ThBreuer/ORB-Hardware/README.md

# ORB-Hardware
OpenRoboticBoard: schematics, layout and documentation
