ThBreuer/ORB-Hardware/Ver-01.xx/Doc/Hardware-Overview.png

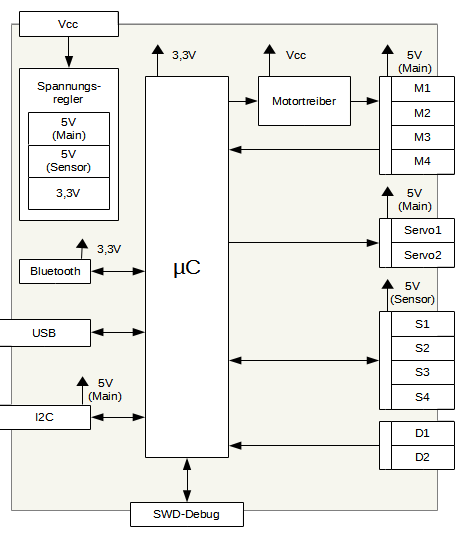
Ver-01.xx/Doc/Hardware-Overview.png
