ThBreuer/ORB-Hardware/Ver-01.xx/KiCad/ORB.kicad_pcb

## KiCad design Ver-01.xx/KiCad/ORB.kicad_pcb (2024-05-07)

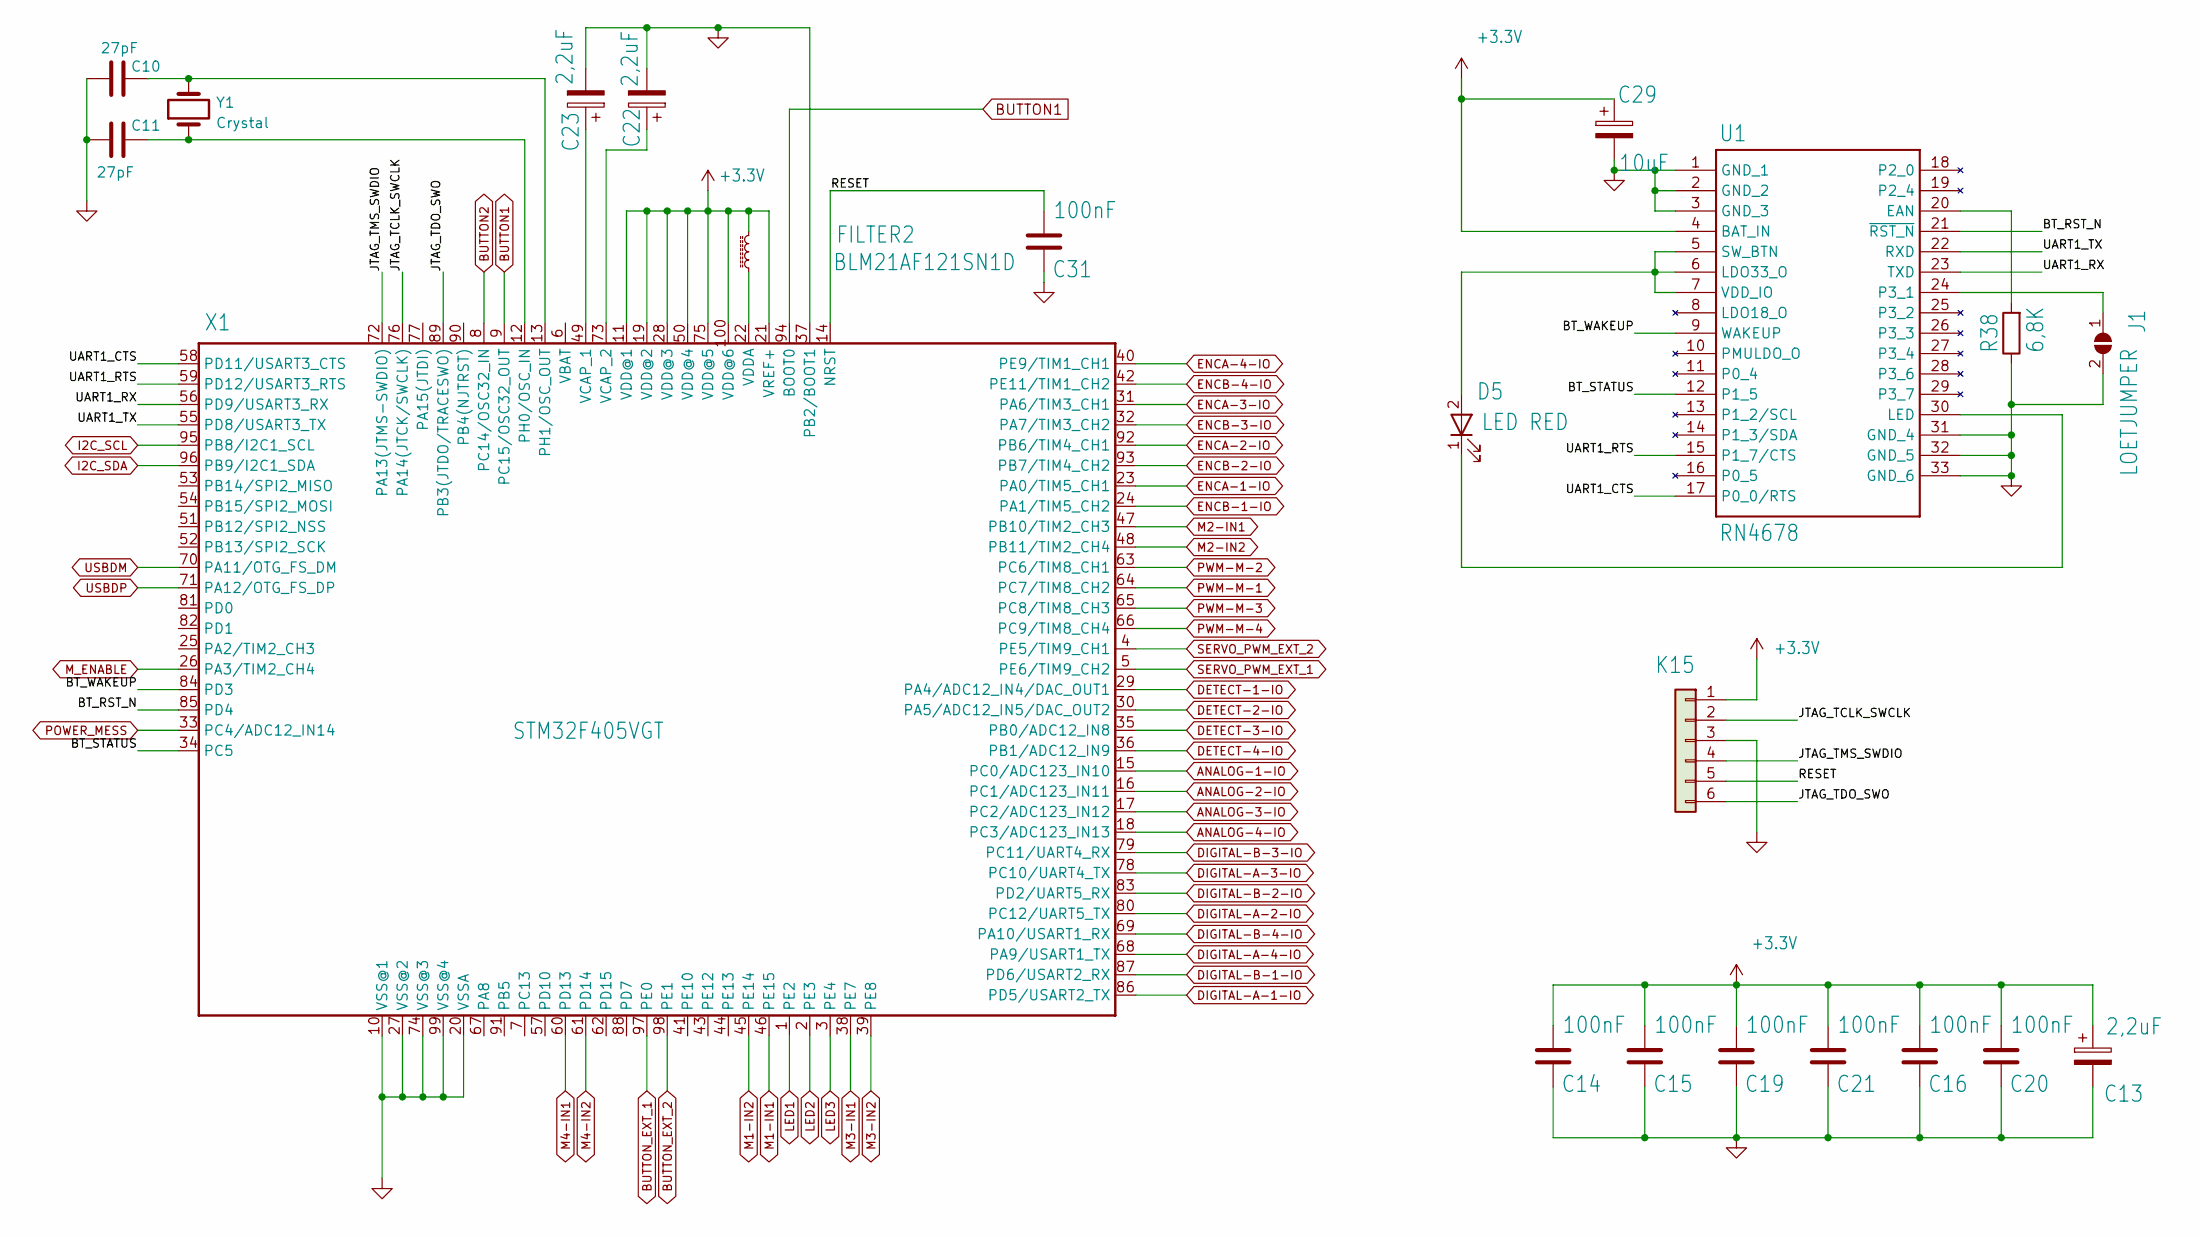
[picture p10: schematic Controller_Bluetooth.kicad_sch, Open Robotic Board (ORB)]

Parts:
C10, C11: 27pF; C_0805_2012Metric; MPN C0805C270K8HAC7800
C13, C22, C23: 2,2uF; CP_EIA-3216-10_Kemet-I; MPN T491A225K016AT
C14, C15, C16, C19, C20, C21, C31: 100nF; C_0805_2012Metric; MPN C0805C104K5RAC7800
C29: 10uF; CP_EIA-3528-12_Kemet-T; MPN T491B106M025AT
D5: LED RED; LED_0805_2012Metric; MPN QTLP630C7TR
FILTER2: BLM21AF121SN1D; L_0805_2012Metric; MPN BLM21AG121SN1D
J1: LOETJUMPER; SolderJumper-2_P1.3mm_Open_Pad1.0x1.5mm; MPN not mounted
K15: Stiftleiste_1x06; PinHeader_1x06_P2.54mm_Vertical; MPN not mounted
R38: 6,8K; R_0603_1608Metric; MPN RC0603FR-136K8L
U1: RN4678; MODULE_RN4678-V_RM100; MPN RN4678-V/RM113
X1: STM32F405VGT; LQFP-100_14x14mm_P0.5mm; MPN STM32F405VGT6
Y1: Crystal; Crystal_SMD_Abracon_ABM3-2Pin_5.0x3.2mm; MPN ECS-80-18-30-JGN-TR

Connections:
+3V3: C13.1, C14.2, C15.2, C16.2, C19.2, C20.2, C21.2, C29.1, FILTER2.2, K15.1, U1.4 (BAT_IN), X1.11 (VDD@1), X1.19 (VDD@2), X1.21 (VREF+), X1.28 (VDD@3), X1.50 (VDD@4), X1.75 (VDD@5), X1.100 (VDD@6); also elsewhere on the board
/Controller, Bluetooth/BT_RST_N: U1.21 (~RST_N), X1.85 (PD4)
/Controller, Bluetooth/BT_STATUS: U1.12 (P1_5), X1.34 (PC5)
/Controller, Bluetooth/BT_WAKEUP: U1.9 (WAKEUP), X1.84 (PD3)
/Controller, Bluetooth/JTAG_TCLK_SWCLK: K15.2, X1.76 (PA14(JTCK/SWCLK))
/Controller, Bluetooth/JTAG_TDO_SWO: K15.6, X1.89 (PB3(JTDO/TRACESWO))
/Controller, Bluetooth/JTAG_TMS_SWDIO: K15.4, X1.72 (PA13(JTMS-SWDIO))
/Controller, Bluetooth/RESET: C31.2, K15.5, X1.14 (NRST)
/Controller, Bluetooth/UART1_CTS: U1.17 (P0_0/RTS), X1.58 (PD11/USART3_CTS)
/Controller, Bluetooth/UART1_RTS: U1.15 (P1_7/CTS), X1.59 (PD12/USART3_RTS)
/Controller, Bluetooth/UART1_RX: U1.23 (TXD), X1.56 (PD9/USART3_RX)
/Controller, Bluetooth/UART1_TX: U1.22 (RXD), X1.55 (PD8/USART3_TX)
ANALOG-1-IO: X1.15 (PC0/ADC123_IN10); also elsewhere on the board
ANALOG-2-IO: X1.16 (PC1/ADC123_IN11); also elsewhere on the board
ANALOG-3-IO: X1.17 (PC2/ADC123_IN12); also elsewhere on the board
ANALOG-4-IO: X1.18 (PC3/ADC123_IN13); also elsewhere on the board
BUTTON1: X1.9 (PC15/OSC32_OUT), X1.94 (BOOT0); also elsewhere on the board
BUTTON2: X1.8 (PC14/OSC32_IN); also elsewhere on the board
BUTTON_EXT_1: X1.97 (PE0); also elsewhere on the board
BUTTON_EXT_2: X1.98 (PE1); also elsewhere on the board
DETECT-1-IO: X1.29 (PA4/ADC12_IN4/DAC_OUT1); also elsewhere on the board
DETECT-2-IO: X1.30 (PA5/ADC12_IN5/DAC_OUT2); also elsewhere on the board
DETECT-3-IO: X1.35 (PB0/ADC12_IN8); also elsewhere on the board
DETECT-4-IO: X1.36 (PB1/ADC12_IN9); also elsewhere on the board
DIGITAL-A-1-IO: X1.86 (PD5/USART2_TX); also elsewhere on the board
DIGITAL-A-2-IO: X1.80 (PC12/UART5_TX); also elsewhere on the board
DIGITAL-A-3-IO: X1.78 (PC10/UART4_TX); also elsewhere on the board
DIGITAL-A-4-IO: X1.68 (PA9/USART1_TX); also elsewhere on the board
DIGITAL-B-1-IO: X1.87 (PD6/USART2_RX); also elsewhere on the board
DIGITAL-B-2-IO: X1.83 (PD2/UART5_RX); also elsewhere on the board
DIGITAL-B-3-IO: X1.79 (PC11/UART4_RX); also elsewhere on the board
DIGITAL-B-4-IO: X1.69 (PA10/USART1_RX); also elsewhere on the board
ENCA-1-IO: X1.23 (PA0/TIM5_CH1); also elsewhere on the board
ENCA-2-IO: X1.92 (PB6/TIM4_CH1); also elsewhere on the board
ENCA-3-IO: X1.31 (PA6/TIM3_CH1); also elsewhere on the board
ENCA-4-IO: X1.40 (PE9/TIM1_CH1); also elsewhere on the board
ENCB-1-IO: X1.24 (PA1/TIM5_CH2); also elsewhere on the board
ENCB-2-IO: X1.93 (PB7/TIM4_CH2); also elsewhere on the board
ENCB-3-IO: X1.32 (PA7/TIM3_CH2); also elsewhere on the board
ENCB-4-IO: X1.42 (PE11/TIM1_CH2); also elsewhere on the board
GND: C10.1, C11.1, C13.2, C14.1, C15.1, C16.1, C19.1, C20.1, C21.1, C22.2, C23.2, C29.2, C31.1, J1.2 (B), K15.3, R38.1, U1.1 (GND_1), U1.2 (GND_2), U1.3 (GND_3), U1.31 (GND_4), U1.32 (GND_5), U1.33 (GND_6), X1.10 (VSS@1), X1.20 (VSSA), X1.27 (VSS@2), X1.37 (PB2/BOOT1), X1.74 (VSS@3), X1.99 (VSS@4); also elsewhere on the board
I2C_SCL: X1.95 (PB8/I2C1_SCL); also elsewhere on the board
I2C_SDA: X1.96 (PB9/I2C1_SDA); also elsewhere on the board
LED1: X1.1 (PE2); also elsewhere on the board
LED2: X1.2 (PE3); also elsewhere on the board
LED3: X1.3 (PE4); also elsewhere on the board
M1-IN1: X1.46 (PE15); also elsewhere on the board
M1-IN2: X1.45 (PE14); also elsewhere on the board
M2-IN1: X1.47 (PB10/TIM2_CH3); also elsewhere on the board
M2-IN2: X1.48 (PB11/TIM2_CH4); also elsewhere on the board
M3-IN1: X1.38 (PE7); also elsewhere on the board
M3-IN2: X1.39 (PE8); also elsewhere on the board
M4-IN1: X1.60 (PD13); also elsewhere on the board
M4-IN2: X1.61 (PD14); also elsewhere on the board
M_ENABLE: X1.26 (PA3/TIM2_CH4); also elsewhere on the board
unnamed: D5.2 (A), U1.5 (SW_BTN), U1.6 (LDO33_O), U1.7 (VDD_IO)
unnamed: D5.1 (K), U1.30 (LED)
unnamed: J1.1 (A), U1.24 (P3_1)
unnamed: R38.2, U1.20 (EAN)
unnamed: C11.2, X1.12 (PH0/OSC_IN), Y1.1
unnamed: C10.2, X1.13 (PH1/OSC_OUT), Y1.2
unnamed: C23.1, X1.49 (VCAP_1)
unnamed: C22.1, X1.73 (VCAP_2)
unnamed: FILTER2.1, X1.22 (VDDA)
POWER_MESS: X1.33 (PC4/ADC12_IN14); also elsewhere on the board
PWM-M-1: X1.64 (PC7/TIM8_CH2); also elsewhere on the board
PWM-M-2: X1.63 (PC6/TIM8_CH1); also elsewhere on the board
PWM-M-3: X1.65 (PC8/TIM8_CH3); also elsewhere on the board
PWM-M-4: X1.66 (PC9/TIM8_CH4); also elsewhere on the board
SERVO_PWM_EXT_1: X1.5 (PE6/TIM9_CH2); also elsewhere on the board
SERVO_PWM_EXT_2: X1.4 (PE5/TIM9_CH1); also elsewhere on the board
USBDM: X1.70 (PA11/OTG_FS_DM); also elsewhere on the board
USBDP: X1.71 (PA12/OTG_FS_DP); also elsewhere on the board

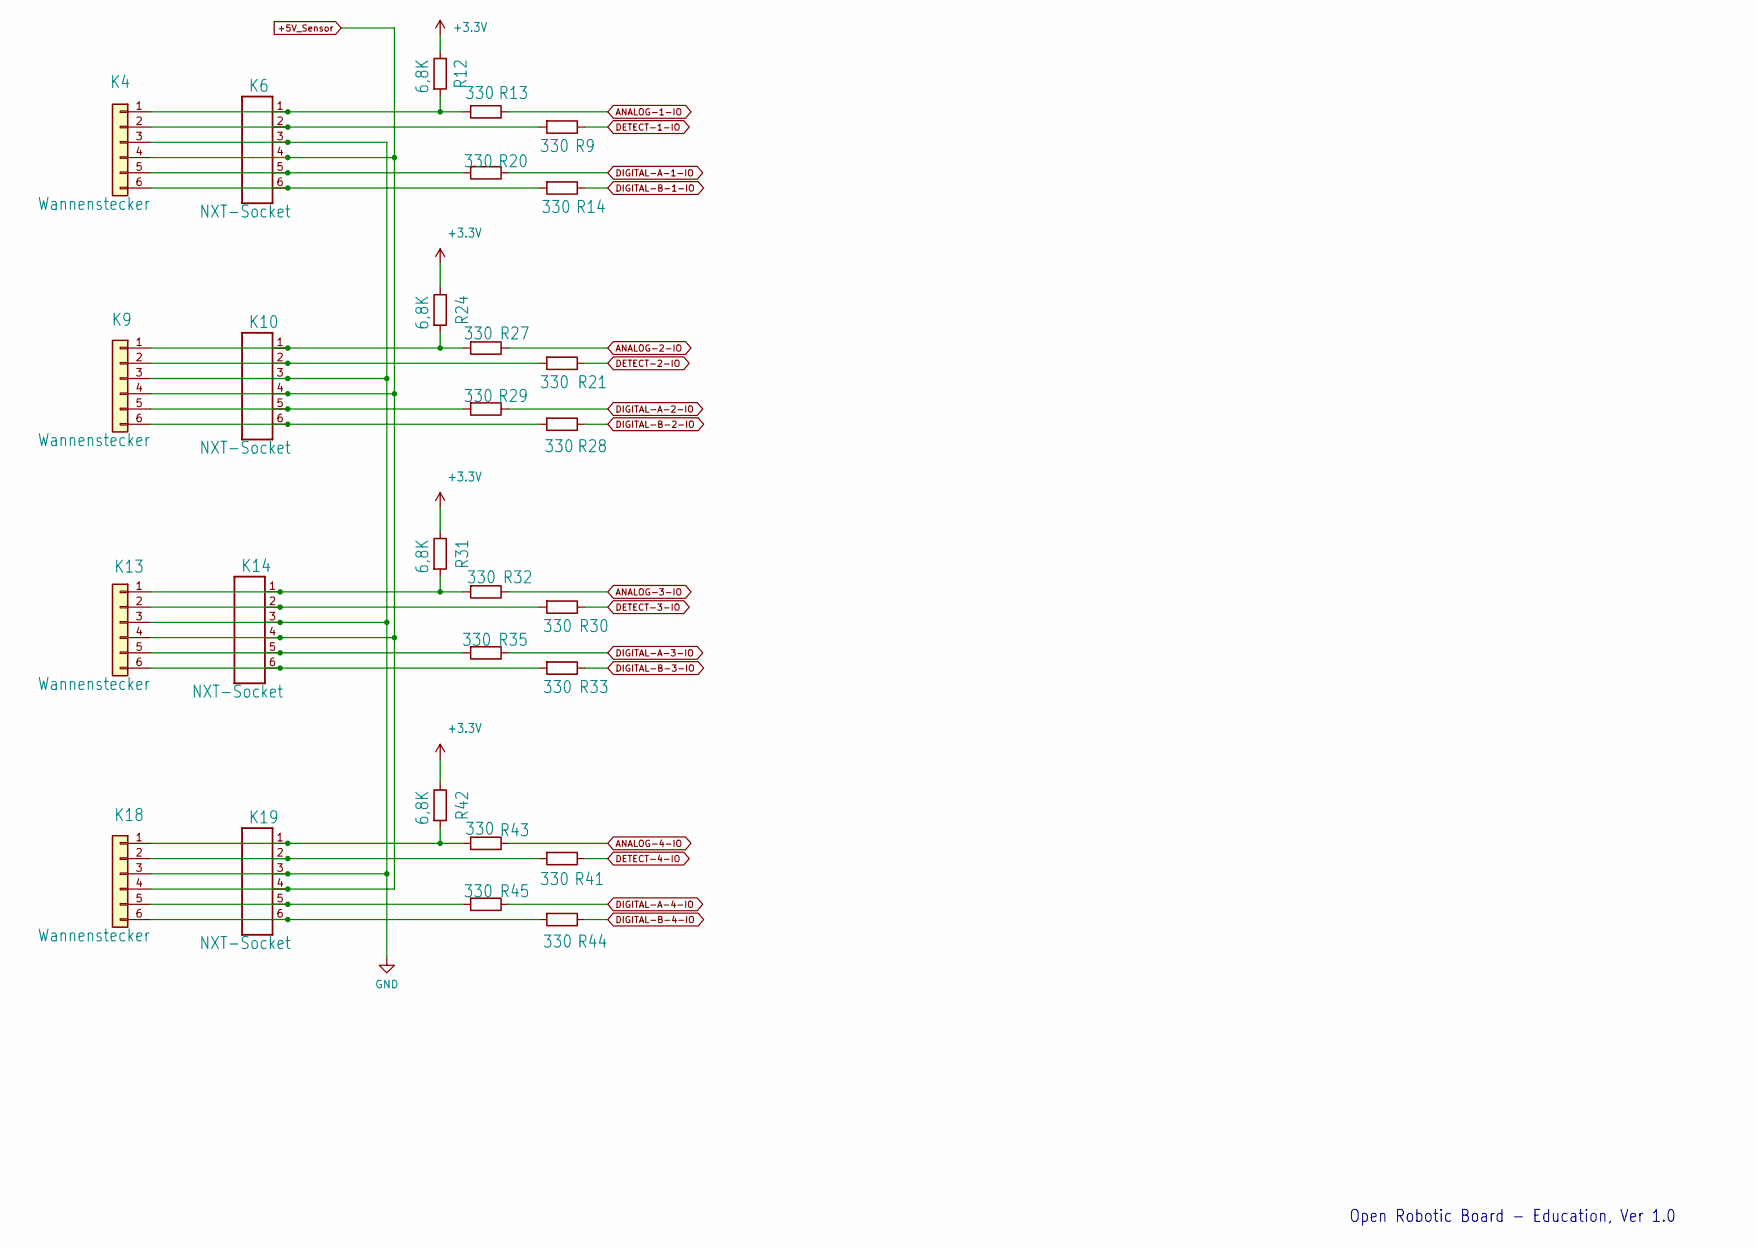
[picture p11: schematic Sensor_Ports.kicad_sch, Open Robotic Board (ORB)]

Parts:
K4, K9, K13, K18: Wannenstecker; IDC-Header_2x03_P2.54mm_Vertical; MPN not mounted
K6, K10, K14, K19: NXT-Socket; NXT-SOCKET; MPN NXT/EV3 Compatible (female) Sockets
R9, R13, R14, R20, R21, R27, R28, R29, R30, R32, R33, R35, R41, R43, R44, R45: 330; R_0603_1608Metric; MPN RC0603FR-10330RL
R12, R24, R31, R42: 6,8K; R_0603_1608Metric; MPN RC0603FR-136K8L

Connections:
+3V3: R12.1, R24.1, R31.1, R42.1; also elsewhere on the board
+5V_Sensor: K4.4, K6.4, K9.4, K10.4, K13.4, K14.4, K18.4, K19.4; also elsewhere on the board
ANALOG-1-IO: R13.1; also elsewhere on the board
ANALOG-2-IO: R27.1; also elsewhere on the board
ANALOG-3-IO: R32.1; also elsewhere on the board
ANALOG-4-IO: R43.1; also elsewhere on the board
DETECT-1-IO: R9.1; also elsewhere on the board
DETECT-2-IO: R21.1; also elsewhere on the board
DETECT-3-IO: R30.1; also elsewhere on the board
DETECT-4-IO: R41.1; also elsewhere on the board
DIGITAL-A-1-IO: R20.1; also elsewhere on the board
DIGITAL-A-2-IO: R29.1; also elsewhere on the board
DIGITAL-A-3-IO: R35.1; also elsewhere on the board
DIGITAL-A-4-IO: R45.1; also elsewhere on the board
DIGITAL-B-1-IO: R14.1; also elsewhere on the board
DIGITAL-B-2-IO: R28.1; also elsewhere on the board
DIGITAL-B-3-IO: R33.1; also elsewhere on the board
DIGITAL-B-4-IO: R44.1; also elsewhere on the board
GND: K4.3, K6.3, K9.3, K10.3, K13.3, K14.3, K18.3, K19.3; also elsewhere on the board
unnamed: K4.1, K6.1, R12.2, R13.2
unnamed: K4.2, K6.2, R9.2
unnamed: K4.5, K6.5, R20.2
unnamed: K4.6, K6.6, R14.2
unnamed: K9.1, K10.1, R24.2, R27.2
unnamed: K9.2, K10.2, R21.2
unnamed: K9.5, K10.5, R29.2
unnamed: K9.6, K10.6, R28.2
unnamed: K13.1, K14.1, R31.2, R32.2
unnamed: K13.2, K14.2, R30.2
unnamed: K13.5, K14.5, R35.2
unnamed: K13.6, K14.6, R33.2
unnamed: K18.1, K19.1, R42.2, R43.2
unnamed: K18.2, K19.2, R41.2
unnamed: K18.5, K19.5, R45.2
unnamed: K18.6, K19.6, R44.2

Notes on the sheet:
Open Robotic Board - Education, Ver 1.0

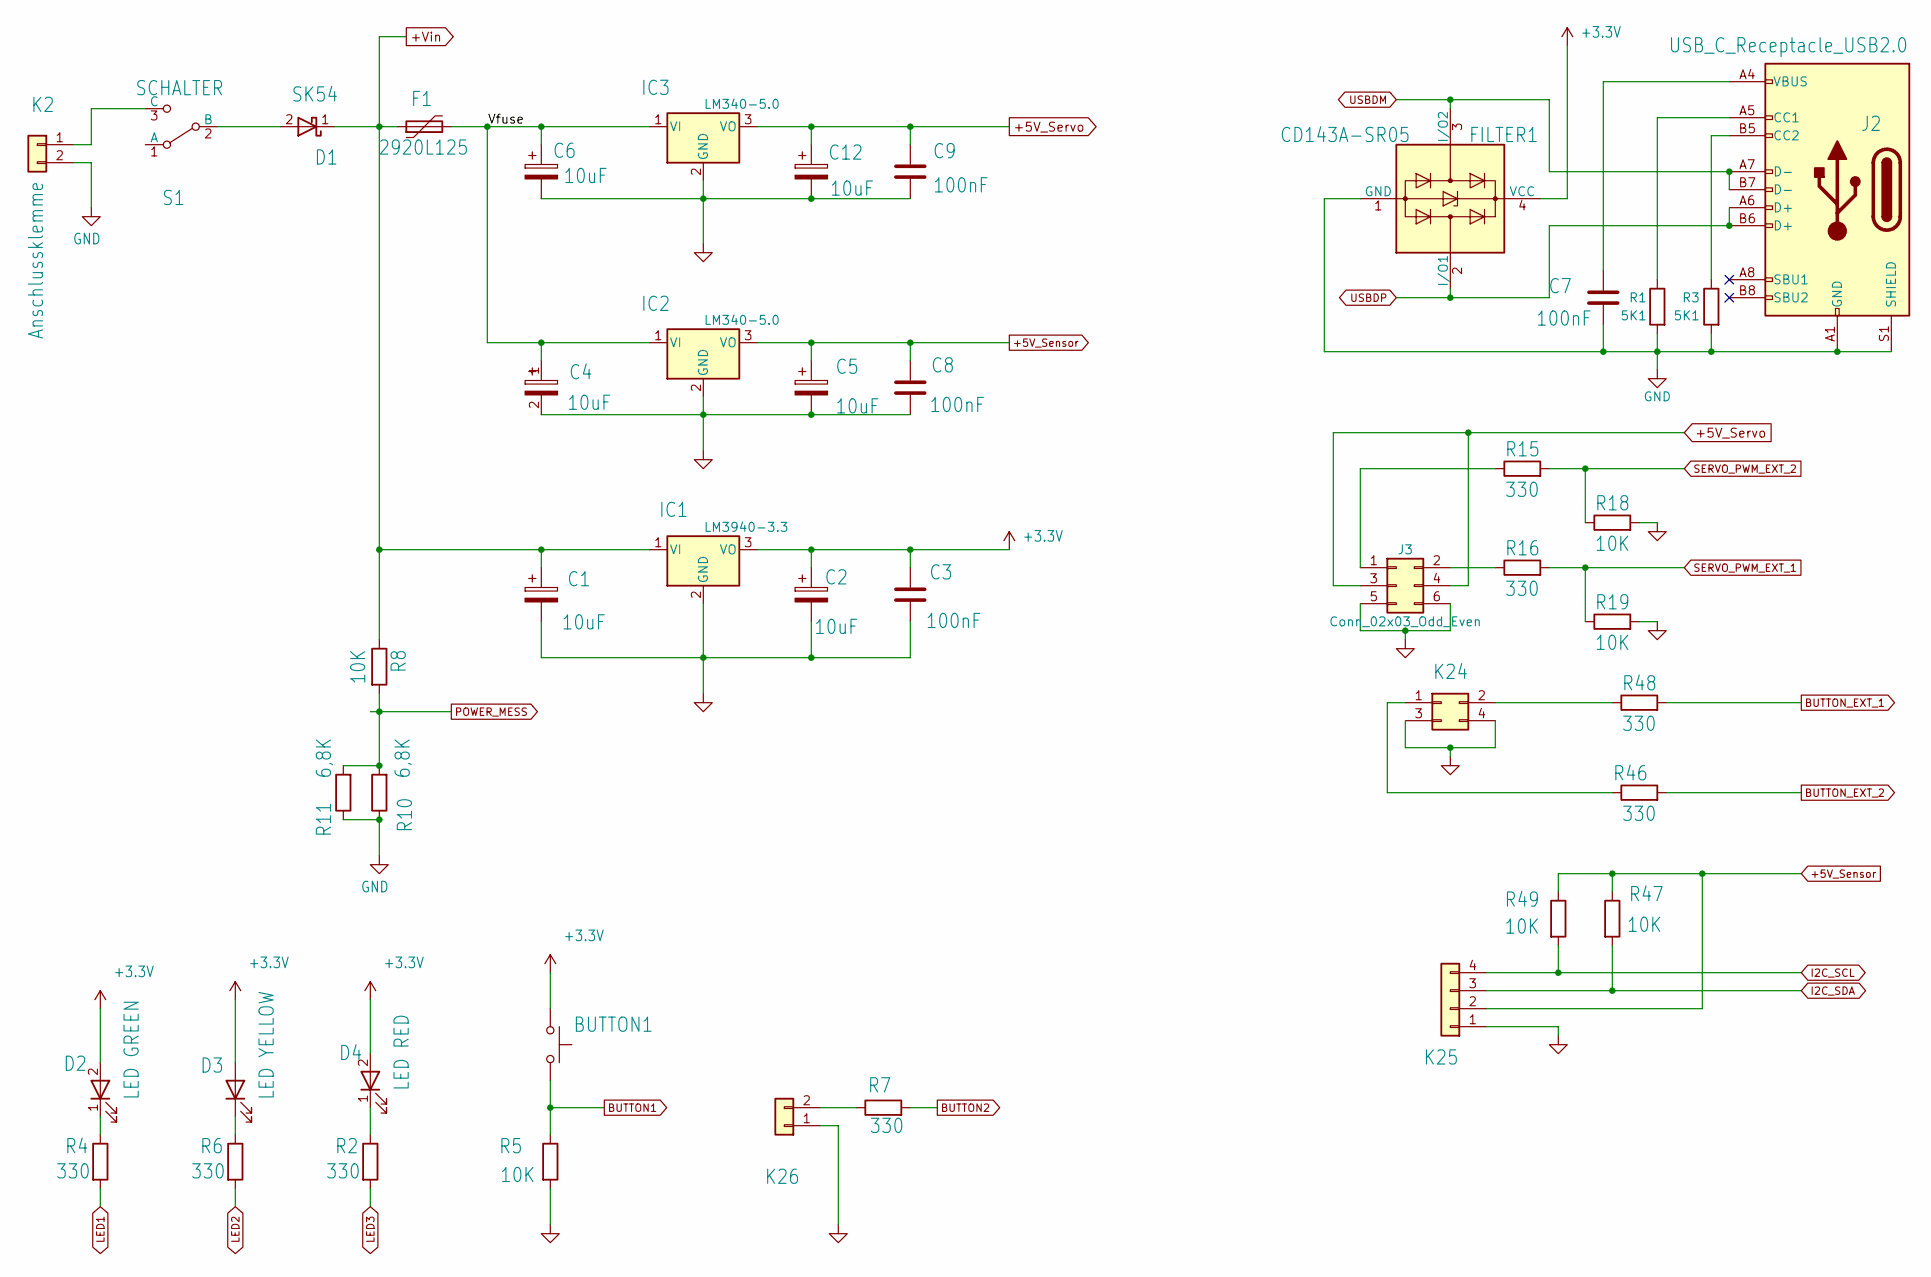
[picture p12: schematic Power_LED_Tasten_IO.kicad_sch, Open Robotic Board (ORB)]

Parts:
BUTTON1: Taster_SMD; SW_Push_1P1T_NO_6x6mm_H9.5mm; MPN PTS645SL70SMTR92 LFS
C1, C2, C4, C5, C6, C12: 10uF; CP_EIA-3528-12_Kemet-T; MPN T491B106M025AT
C3, C7, C8, C9: 100nF; C_0805_2012Metric; MPN C0805C104K5RAC7800
D1: SK54; D_SMB; MPN SK54B-LTP
D2: LED GREEN; LED_0805_2012Metric; MPN QTLP630C4TR
D3: LED YELLOW; LED_0805_2012Metric; MPN QTLP630C3TR
D4: LED RED; LED_0805_2012Metric; MPN QTLP630C7TR
F1: 2920L125; Fuse_2920_7451Metric; MPN 2920L125PR
FILTER1: CD143A-SR05; SOT-143; MPN CD143A-SR05LC
IC1: LM3940-3.3; SOT-223-3_TabPin2; MPN LM3940IMPX-3.3/NOPB
IC2, IC3: LM340-5.0; SOT-223-3_TabPin2; MPN LM340MPX-5.0/NOPB
J2: USB_C_Receptacle_USB2.0; USB_C_Receptacle_G-Switch_GT-USB-7010ASV; MPN GT-USB-7010ASV
J3: Conn_02x03_Odd_Even; PinHeader_2x03_P2.54mm_Horizontal; MPN PH2RA-06-UA
K2: Anschlussklemme; PinHeader_1x02_P2.54mm_Horizontal; MPN PH1RB-02-UA
K24: Stiftleiste_2x02; PinHeader_2x02_P2.54mm_Horizontal; MPN PH2RA-04-UA
K25: Stiftleiste_1x04; PinHeader_1x04_P2.54mm_Vertical; MPN not mounted
K26: Stiftleiste_1x02_G_2,54; PinHeader_1x02_P2.54mm_Vertical; MPN not mounted
R1, R3: 5K1; R_0603_1608Metric; MPN RC0603FR-135K1L
R2, R4, R6, R7, R15, R16, R46, R48: 330; R_0603_1608Metric; MPN RC0603FR-10330RL
R5, R8, R18, R19, R47, R49: 10K; R_0603_1608Metric; MPN RC0603FR-0710KP
R10, R11: 6,8K; R_0603_1608Metric; MPN RC0603FR-136K8L
S1: SCHALTER; SW_500SSP1S1M7QEA; MPN 500SSP1S1M7QEA

Connections:
+3V3: BUTTON1.1, C2.1, C3.2, D2.2 (A), D3.2 (A), D4.2 (A), FILTER1.4 (VCC), IC1.3 (VO); also elsewhere on the board
+5V_Sensor: C5.1, C8.2, IC2.3 (VO), K25.2, R47.1, R49.1; also elsewhere on the board
+5V_Servo: C9.2, C12.1, IC3.3 (VO), J3.3, J3.4
+Vin: C1.1, D1.1 (K), F1.1, IC1.1 (VI), R8.1; also elsewhere on the board
/Power, LED,Tasten, IO/Vfuse: C4.1, C6.1, F1.2, IC2.1 (VI), IC3.1 (VI)
BUTTON1: BUTTON1.2, R5.1; also elsewhere on the board
BUTTON2: R7.2; also elsewhere on the board
BUTTON_EXT_1: R48.2; also elsewhere on the board
BUTTON_EXT_2: R46.2; also elsewhere on the board
GND: C1.2, C2.2, C3.1, C4.2, C5.2, C6.2, C7.1, C8.1, C9.1, C12.2, FILTER1.1 (GND), IC1.2 (GND), IC2.2 (GND), IC3.2 (GND), J2.A1 (GND), J2.A12 (GND), J2.B1 (GND), J2.B12 (GND), J2.S1 (SHIELD), J3.5, J3.6, K2.2, K24.3, K24.4, K25.1, K26.1, R1.2, R3.2, R5.2, R10.1, R11.1, R18.2, R19.2; also elsewhere on the board
I2C_SCL: K25.4, R49.2; also elsewhere on the board
I2C_SDA: K25.3, R47.2; also elsewhere on the board
LED1: R4.2; also elsewhere on the board
LED2: R6.2; also elsewhere on the board
LED3: R2.2; also elsewhere on the board
unnamed: C7.2, J2.A4 (VBUS), J2.A9 (VBUS), J2.B4 (VBUS), J2.B9 (VBUS)
unnamed: D1.2 (A), S1.2 (B)
unnamed: D2.1 (K), R4.1
unnamed: D3.1 (K), R6.1
unnamed: D4.1 (K), R2.1
unnamed: J2.A5 (CC1), R1.1
unnamed: J2.B5 (CC2), R3.1
unnamed: J3.1, R15.1
unnamed: J3.2, R16.1
unnamed: K2.1, S1.3 (C)
unnamed: K24.1, R46.1
unnamed: K24.2, R48.1
unnamed: K26.2, R7.1
POWER_MESS: R8.2, R10.2, R11.2; also elsewhere on the board
SERVO_PWM_EXT_1: R16.2, R19.1; also elsewhere on the board
SERVO_PWM_EXT_2: R15.2, R18.1; also elsewhere on the board
USBDM: FILTER1.3 (I/O2), J2.A7 (D-), J2.B7 (D-); also elsewhere on the board
USBDP: FILTER1.2 (I/O1), J2.A6 (D+), J2.B6 (D+); also elsewhere on the board

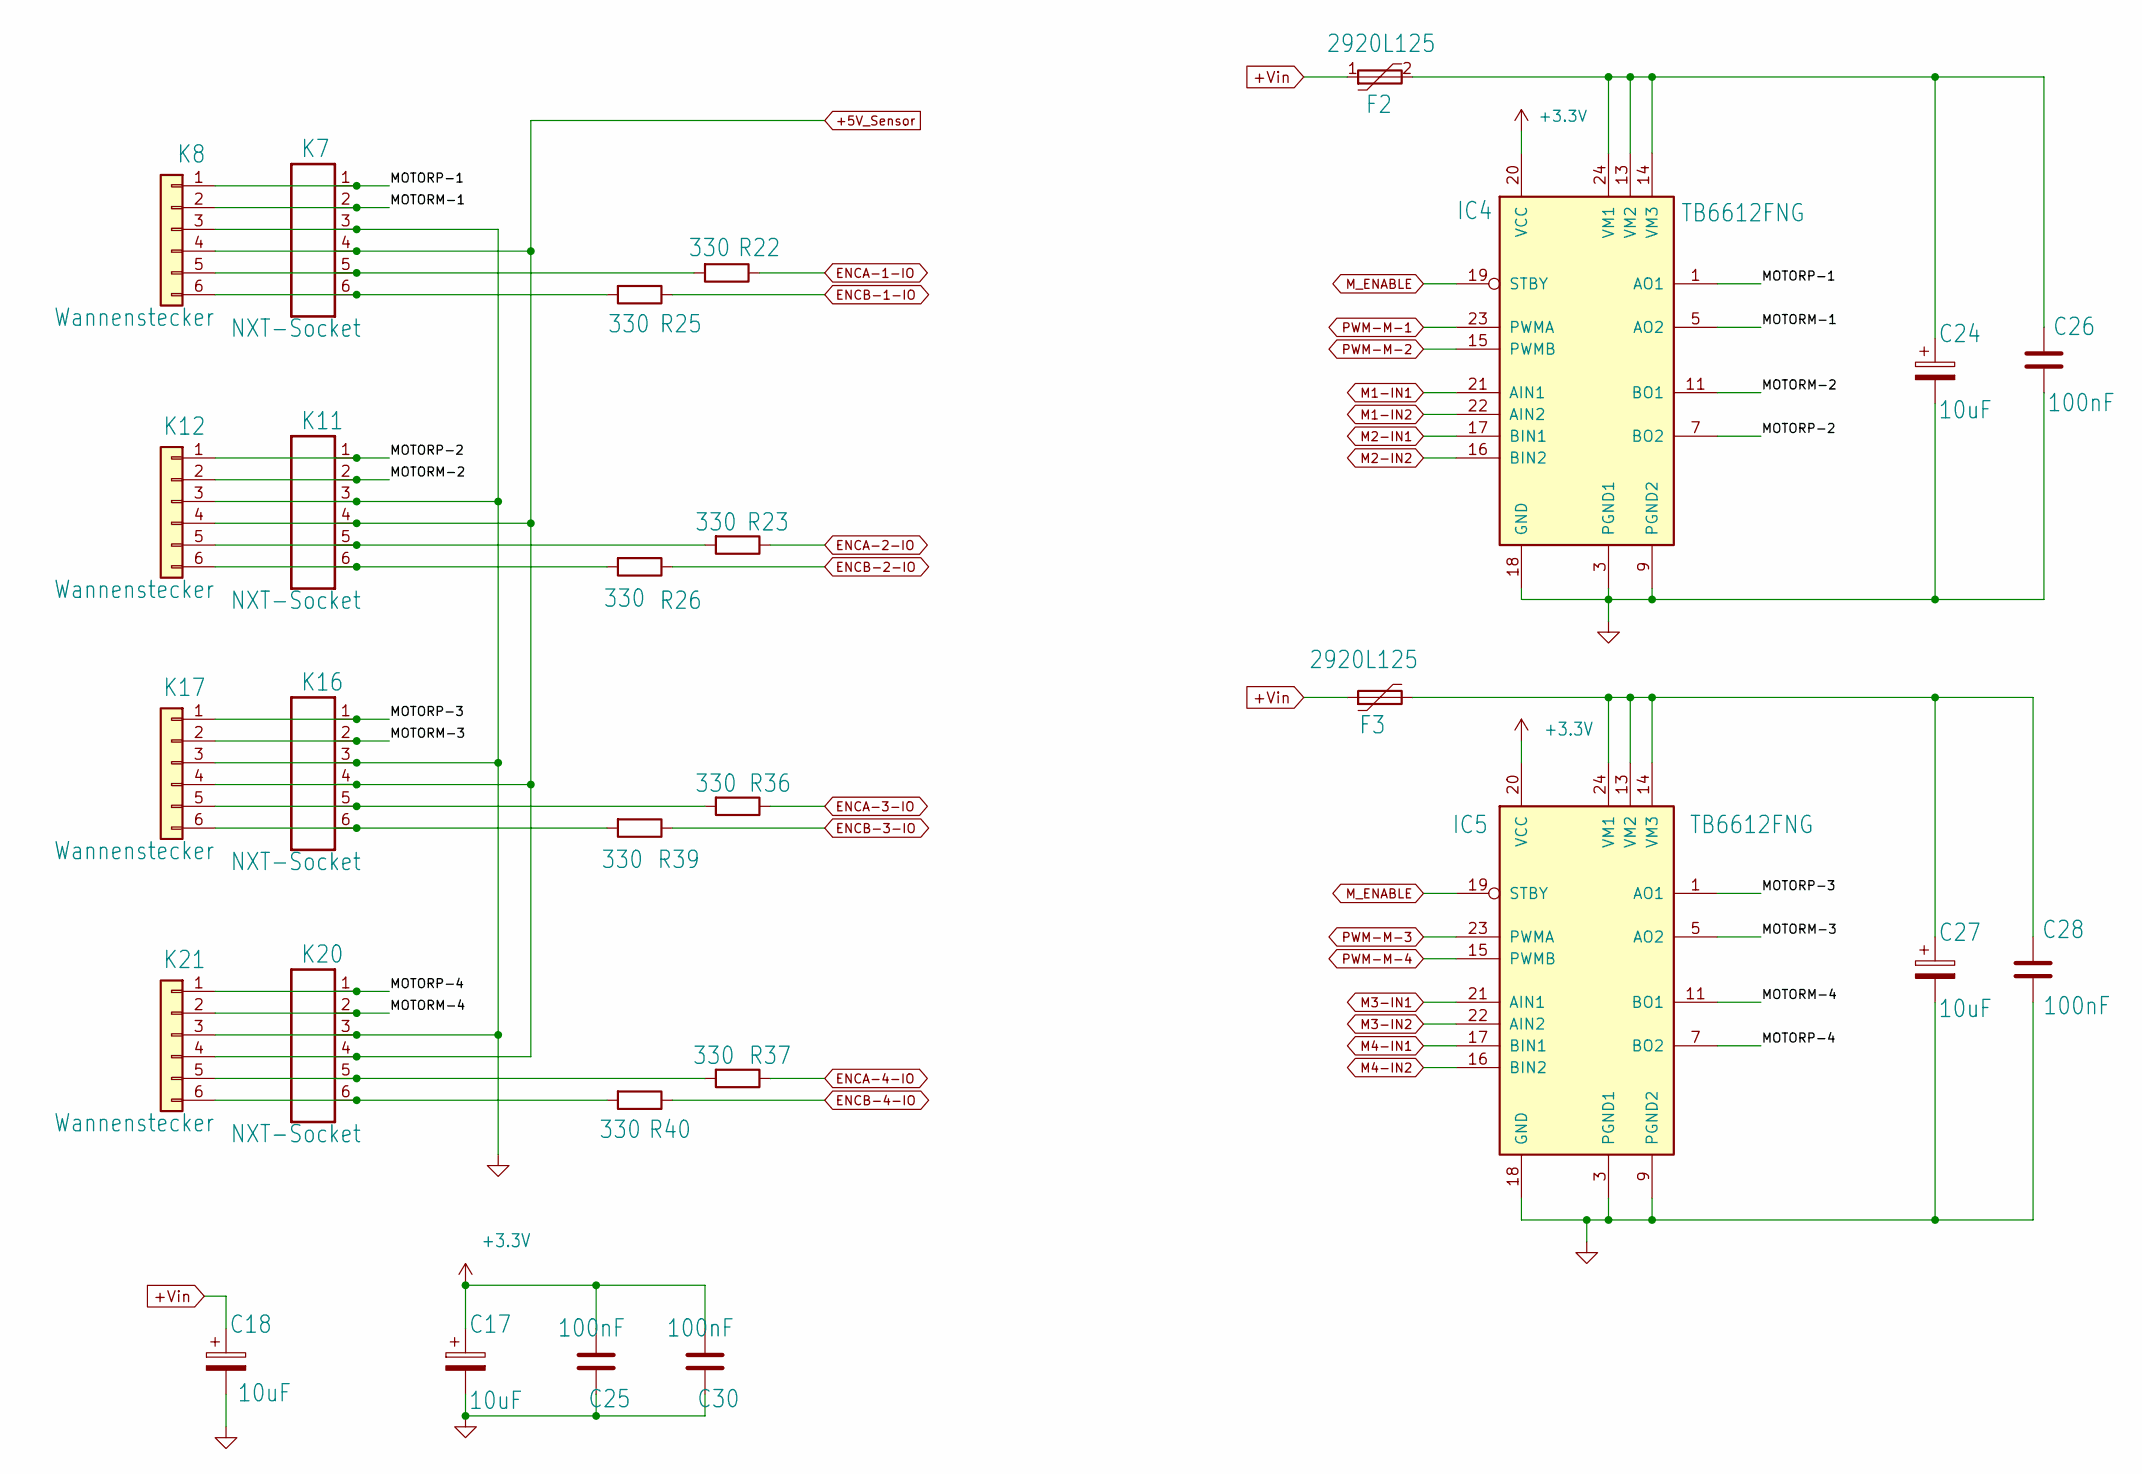
[picture p13: schematic Motor_Ports.kicad_sch, Open Robotic Board (ORB)]

Parts:
C17, C18, C24, C27: 10uF; CP_EIA-3528-12_Kemet-T; MPN T491B106M025AT
C25, C26, C28, C30: 100nF; C_0805_2012Metric; MPN C0805C104K5RAC7800
F2, F3: 2920L125; Fuse_2920_7451Metric; MPN 2920L125PR
IC4, IC5: TB6612FNG; SSOP-24_5.3x8.2mm_P0.65mm; MPN TB6612FNG,C,8,EL
K7, K11, K16, K20: NXT-Socket; NXT-SOCKET; MPN NXT/EV3 Compatible (female) Sockets
K8, K12, K17, K21: Wannenstecker; IDC-Header_2x03_P2.54mm_Vertical; MPN not mounted
R22, R23, R25, R26, R36, R37, R39, R40: 330; R_0603_1608Metric; MPN RC0603FR-10330RL

Connections:
+3V3: C17.1, C25.2, C30.2, IC4.20 (VCC), IC5.20 (VCC); also elsewhere on the board
+5V_Sensor: K7.4, K8.4, K11.4, K12.4, K16.4, K17.4, K20.4, K21.4; also elsewhere on the board
+Vin: C18.1, F2.1, F3.1; also elsewhere on the board
/Motor-Ports/MOTORM-1: IC4.5 (AO2), IC4.6 (AO2), K7.2, K8.2
/Motor-Ports/MOTORM-2: IC4.11 (BO1), IC4.12 (BO1), K11.2, K12.2
/Motor-Ports/MOTORM-3: IC5.5 (AO2), IC5.6 (AO2), K16.2, K17.2
/Motor-Ports/MOTORM-4: IC5.11 (BO1), IC5.12 (BO1), K20.2, K21.2
/Motor-Ports/MOTORP-1: IC4.1 (AO1), IC4.2 (AO1), K7.1, K8.1
/Motor-Ports/MOTORP-2: IC4.7 (BO2), IC4.8 (BO2), K11.1, K12.1
/Motor-Ports/MOTORP-3: IC5.1 (AO1), IC5.2 (AO1), K16.1, K17.1
/Motor-Ports/MOTORP-4: IC5.7 (BO2), IC5.8 (BO2), K20.1, K21.1
ENCA-1-IO: R22.1; also elsewhere on the board
ENCA-2-IO: R23.1; also elsewhere on the board
ENCA-3-IO: R36.1; also elsewhere on the board
ENCA-4-IO: R37.1; also elsewhere on the board
ENCB-1-IO: R25.1; also elsewhere on the board
ENCB-2-IO: R26.1; also elsewhere on the board
ENCB-3-IO: R39.1; also elsewhere on the board
ENCB-4-IO: R40.1; also elsewhere on the board
GND: C17.2, C18.2, C24.2, C25.1, C26.1, C27.2, C28.1, C30.1, IC4.3 (PGND1), IC4.4 (PGND1), IC4.9 (PGND2), IC4.10 (PGND2), IC4.18 (GND), IC5.3 (PGND1), IC5.4 (PGND1), IC5.9 (PGND2), IC5.10 (PGND2), IC5.18 (GND), K7.3, K8.3, K11.3, K12.3, K16.3, K17.3, K20.3, K21.3; also elsewhere on the board
M1-IN1: IC4.21 (AIN1); also elsewhere on the board
M1-IN2: IC4.22 (AIN2); also elsewhere on the board
M2-IN1: IC4.17 (BIN1); also elsewhere on the board
M2-IN2: IC4.16 (BIN2); also elsewhere on the board
M3-IN1: IC5.21 (AIN1); also elsewhere on the board
M3-IN2: IC5.22 (AIN2); also elsewhere on the board
M4-IN1: IC5.17 (BIN1); also elsewhere on the board
M4-IN2: IC5.16 (BIN2); also elsewhere on the board
M_ENABLE: IC4.19 (STBY), IC5.19 (STBY); also elsewhere on the board
unnamed: C24.1, C26.2, F2.2, IC4.13 (VM2), IC4.14 (VM3), IC4.24 (VM1)
unnamed: C27.1, C28.2, F3.2, IC5.13 (VM2), IC5.14 (VM3), IC5.24 (VM1)
unnamed: K7.5, K8.5, R22.2
unnamed: K7.6, K8.6, R25.2
unnamed: K11.5, K12.5, R23.2
unnamed: K11.6, K12.6, R26.2
unnamed: K16.5, K17.5, R36.2
unnamed: K16.6, K17.6, R39.2
unnamed: K20.5, K21.5, R37.2
unnamed: K20.6, K21.6, R40.2
PWM-M-1: IC4.23 (PWMA); also elsewhere on the board
PWM-M-2: IC4.15 (PWMB); also elsewhere on the board
PWM-M-3: IC5.23 (PWMA); also elsewhere on the board
PWM-M-4: IC5.15 (PWMB); also elsewhere on the board

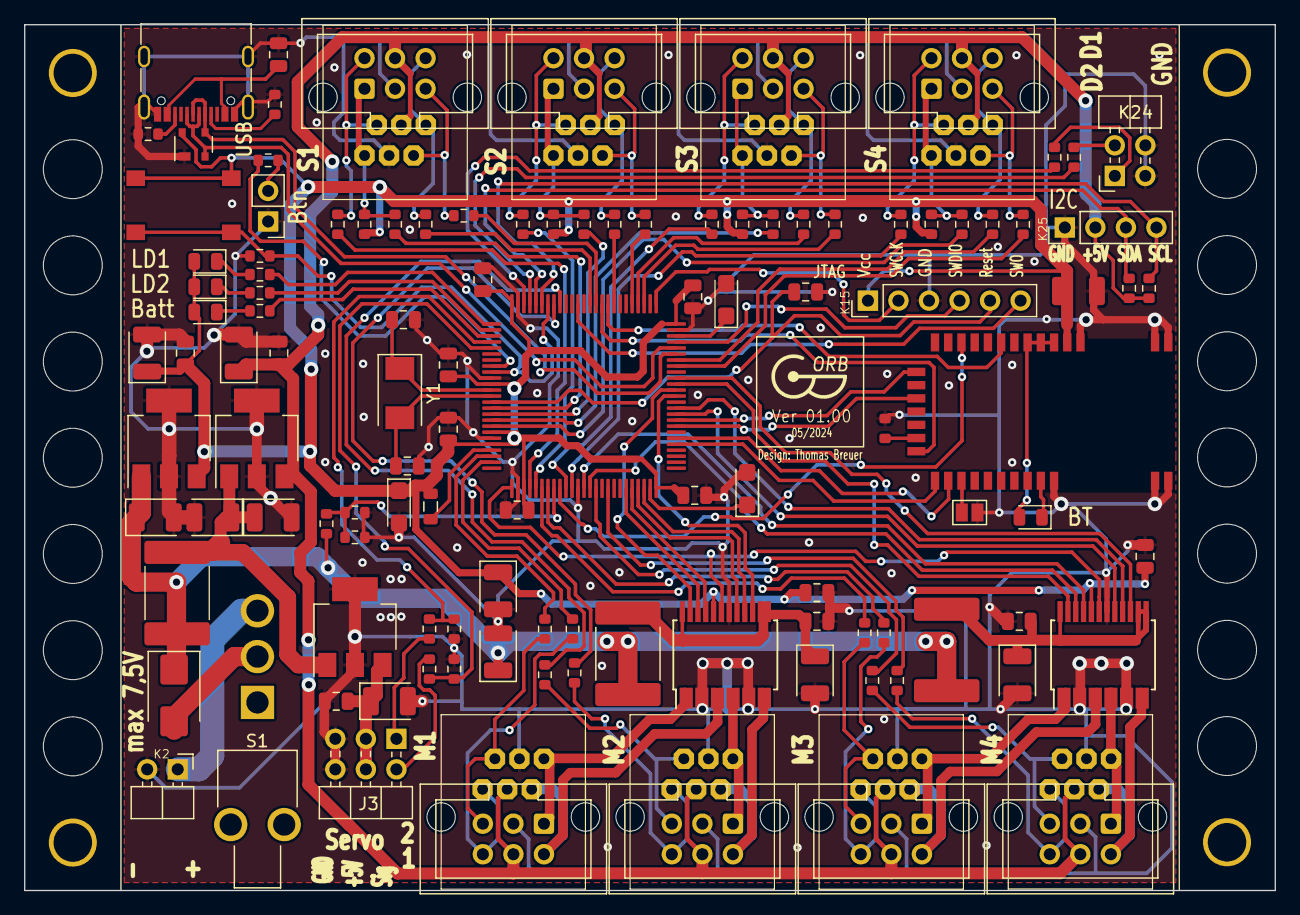
[picture p14: board ORB.kicad_pcb from above]

Board: 2 copper layers, 104.0 x 72.0 mm, 123 parts (0 on the bottom side), 124 nets.

Other parts of the board:
Logo**: Logo
