ThBreuer/ORB-Hardware/(commit log)

2023-11-10 Initial version
    [Controller_Bluetooth.kicad_sch, Motor_Ports.kicad_sch, ORB.kicad_pcb, ORB.kicad_sch, Power_LED_Tasten_IO.kicad_sch, Sensor_Ports.kicad_sch]
2023-11-10 kicad files
2023-11-12 New Logo
    [ORB.kicad_pcb]
2023-11-12 Snap to grid
    [Controller_Bluetooth.kicad_sch, Motor_Ports.kicad_sch, ORB.kicad_sch, Power_LED_Tasten_IO.kicad_sch, Sensor_Ports.kicad_sch]
2023-11-17 Kleinere Optimierungen
    [Controller_Bluetooth.kicad_sch, Motor_Ports.kicad_sch, ORB.kicad_pcb, ORB.kicad_sch, Power_LED_Tasten_IO.kicad_sch]
2023-11-23 R (Crystal) raus, C (Reset) hinzu
    [Controller_Bluetooth.kicad_sch, ORB.kicad_pcb, ORB.kicad_sch]
2024-02-01 Review
    - New Crystal
    - GND plane on front side
    [ORB.kicad_pcb]
2024-02-01 Abstand MotorX-Y kleiner
    [ORB.kicad_pcb]
2024-02-16 Update KiCad 7.x, Crystal changed
    [Controller_Bluetooth.kicad_sch, Motor_Ports.kicad_sch, ORB.kicad_sch, Power_LED_Tasten_IO.kicad_sch, Sensor_Ports.kicad_sch]
2024-05-07 After production test
    Footprint D1 and Y1 changed.
    LED shunt R=330
    [Controller_Bluetooth.kicad_sch, ORB.kicad_pcb, Power_LED_Tasten_IO.kicad_sch]
2024-05-07 USB connector changed
    [ORB.kicad_pcb, Power_LED_Tasten_IO.kicad_sch]
